Kartoffel/WTherm/measurements/13122014.xlsx

Sheet: 13122014
Time | meter value (MJ) | Qin(MJ) | inside (°C) | outside (°C) | dT (°C) | Qloss (MJ) | Qnet (MJ)
6:00:02 | 410 | 0 | 15.3 | 2 | 13.3 | 1.451182539 | -1.451182539 | Constant temperature (12:30-19:30)
6:05:02 | 413 | 3 | 15.3 | 2 | 13.3 | 1.45118254 | 0.09763492124
6:10:02 | 416 | 6 | 15.3 | 2 | 13.3 | 1.451182538 | 1.646452384 | Average dT | 14.29294118 | °C
6:15:01 | 417 | 7 | 15.4 | 2 | 13.4 | 1.457220041 | 1.189232343 | Total energy needed: | 36.38888889 | KWh
6:20:01 | 419 | 9 | 15.4 | 2 | 13.4 | 1.462093685 | 1.727138658 | Total time: | 7:00:00 | Hours
6:25:02 | 421 | 11 | 15.5 | 2 | 13.5 | 1.477914848 | 2.24922381 | Power needed: | 5.20 | KW
6:30:01 | 423 | 13 | 15.5 | 2.1 | 13.4 | 1.457220041 | 2.792003769 | Ct = | 363.704897 | W/K
6:35:02 | 425 | 15 | 15.6 | 2.2 | 13.4 | 1.466967332 | 3.325036437
6:40:02 | 427 | 17 | 15.7 | 2.2 | 13.5 | 1.473004836 | 3.852031601 | Heating up (06:00-12:00)
6:45:02 | 429 | 19 | 15.8 | 2.3 | 13.5 | 1.473004831 | 4.37902677
6:50:02 | 431 | 21 | 15.8 | 2.3 | 13.5 | 1.473004834 | 4.906021936 | Total energy | 155 | MJ
6:55:02 | 433 | 23 | 15.9 | 2.3 | 13.6 | 1.483915978 | 5.422105958 | Total time | 6.00 | Hours
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
