Kartoffel/WTherm/measurements/KNMI.xlsx

YYYYMMDD | HH | Time | Outside | Inside | Source for outside temperatures: ROYAL NETHERLANDS METEOROLOGICAL INSTITUTE (KNMI)
20141215 | 1 | 20141215 1:00 | 3.3 | 18.0 | Station: De Bilt, Utrecht, The Netherlands
20141215 | 2 | 20141215 2:00 | 3.6 | 18.0
20141215 | 3 | 20141215 3:00 | 3.9 | 18.0
20141215 | 4 | 20141215 4:00 | 3.9 | 18.0
20141215 | 5 | 20141215 5:00 | 4.0 | 18.0 | U (W/K) | 364
20141215 | 6 | 20141215 6:00 | 4.4 | 18.0 | Day | Tout (°C) | Tin (°C) | Time(hours) | Wasted energy (KWh)
20141215 | 7 | 20141215 7:00 | 4.9 | 18.0 | 4 | 10.8 | 20.0 | 1.3 | 4.35344
20141215 | 8 | 20141215 8:00 | 5.2 | 18.0 | 5 | 11.5 | 20.0 | 1.4 | 4.3316
20141215 | 9 | 20141215 9:00 | 5.6 | 18.0 | 6 | 7.8 | 20.0 | 0.9 | 3.99672
20141215 | 10 | 20141215 10:00 | 6.1 | 18.0 | 7 | 6.5 | 20.0 | 0.6 | 2.9484
20141215 | 11 | 20141215 11:00 | 6.7 | 18.0 |  |  |  | Total | 15.63016 | KWh
20141215 | 12 | 20141215 12:00 | 7.0 | 18.0 |  |  |  |  | 7.31491488 | GJ
20141215 | 13 | 20141215 13:00 | 7.6 | 18.0
20141215 | 14 | 20141215 14:00 | 7.2 | 18.0 |  |  |  | €/GJ | 22.64
20141215 | 15 | 20141215 15:00 | 6.7 | 18.0 |  |  |  | € | 165.6096729
20141215 | 16 | 20141215 16:00 | 6.3 | 18.0
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
