Kartoffel/WTherm/report/figures/GraphModelTest.png

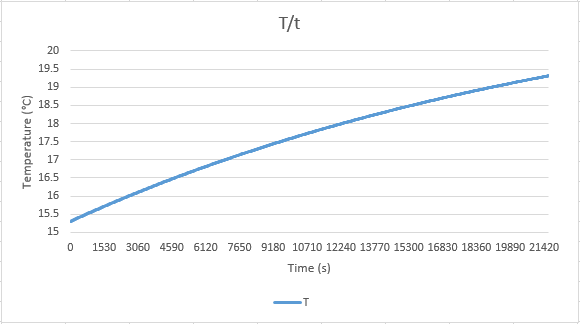
report/figures/GraphModelTest.png
