Kartoffel/WTherm/schematics/relay.pdf

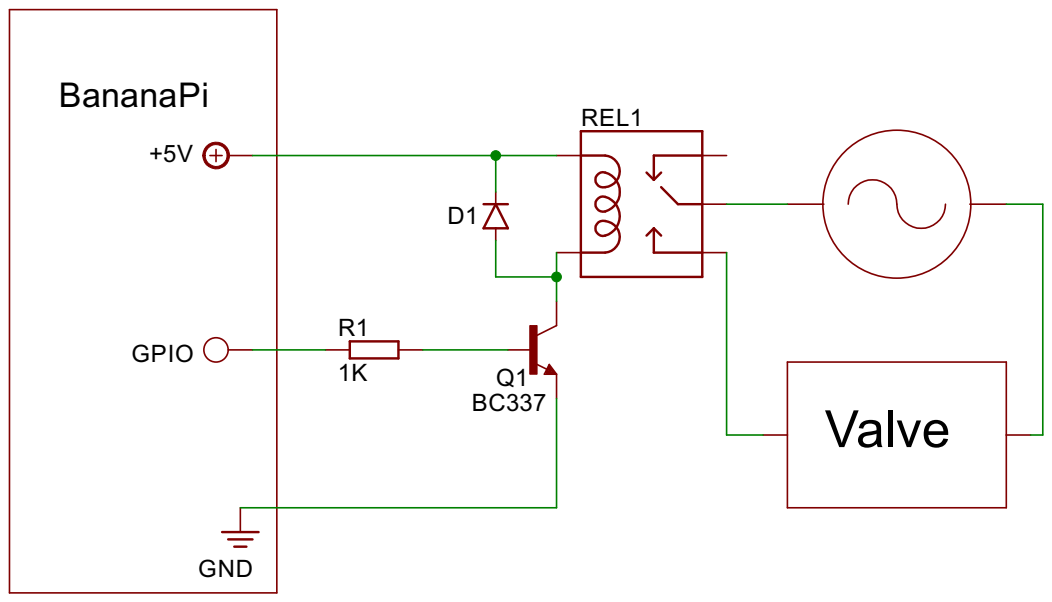
[picture p29: page 1]
