Kartoffel/WTherm/report/figures/by-nc-sa.pdf

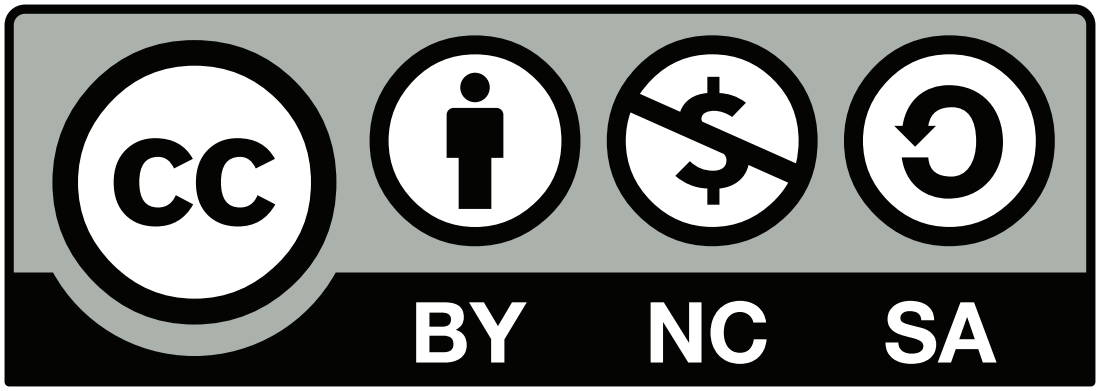
[picture p30: page 1]
