Kartoffel/WTherm/report/figures/overview.pdf

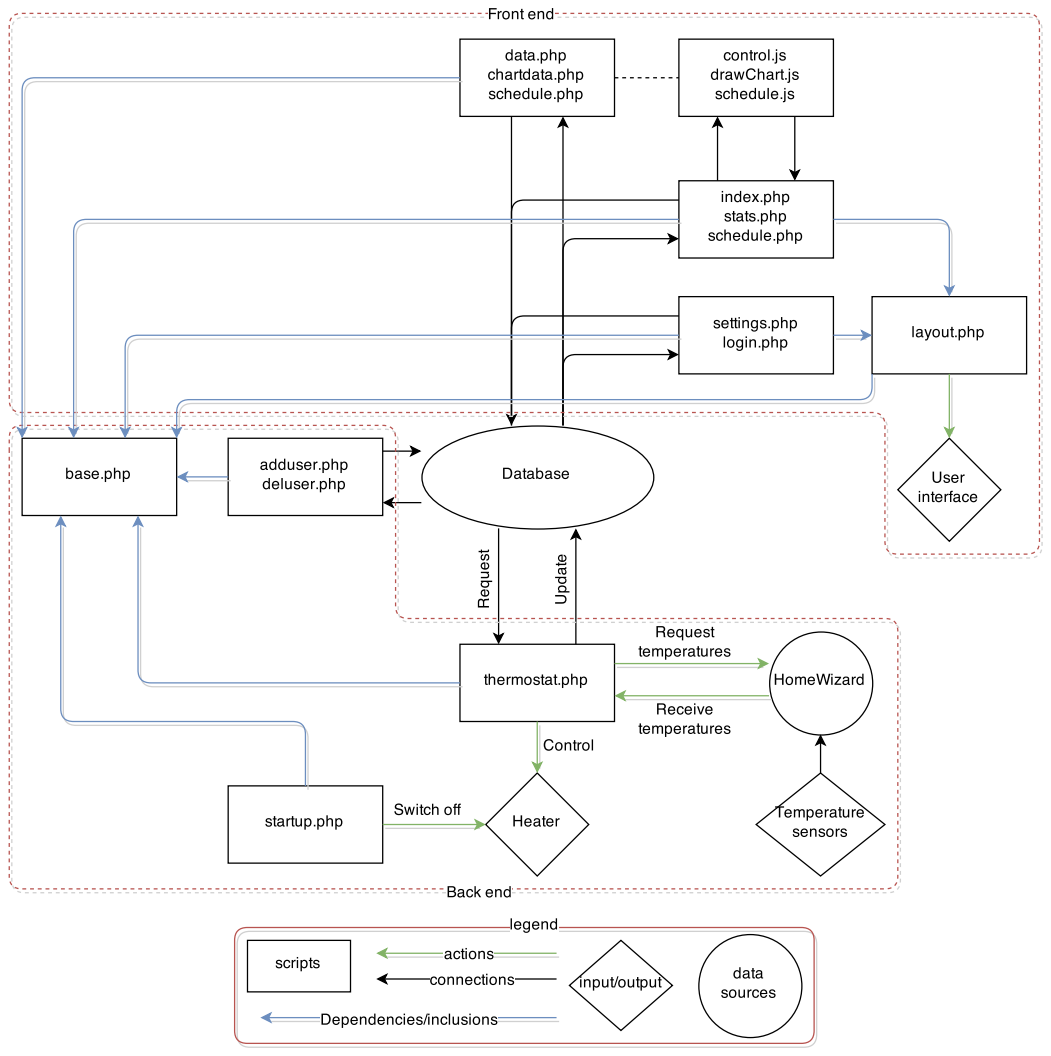
[picture p31: page 1]
