Kartoffel/WTherm/report/figures/thermostat.php.pdf

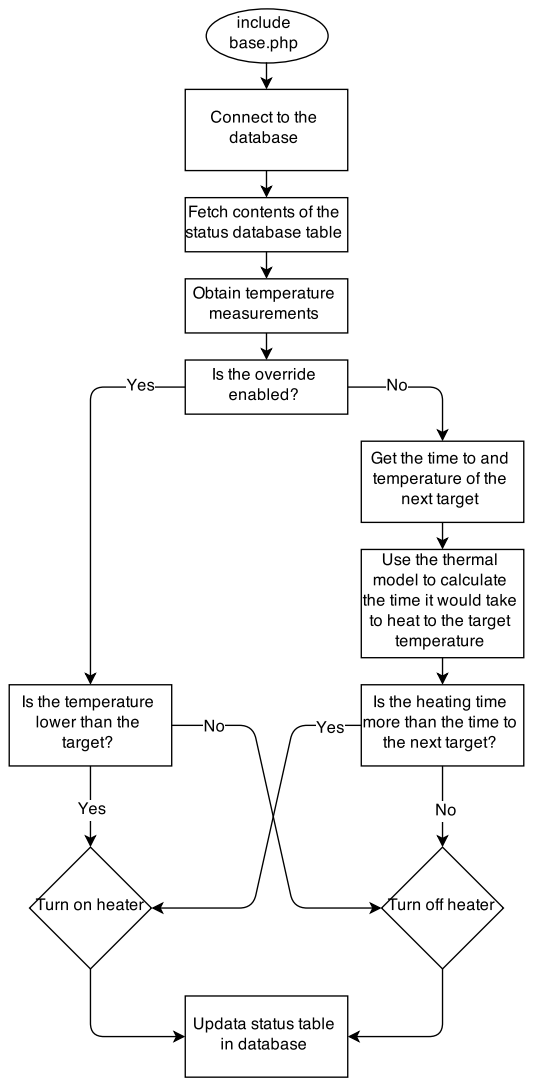
[picture p32: page 1]
