Kartoffel/WTherm/schematics/relay.sch

## EAGLE design schematics/relay.sch (2015-01-18)

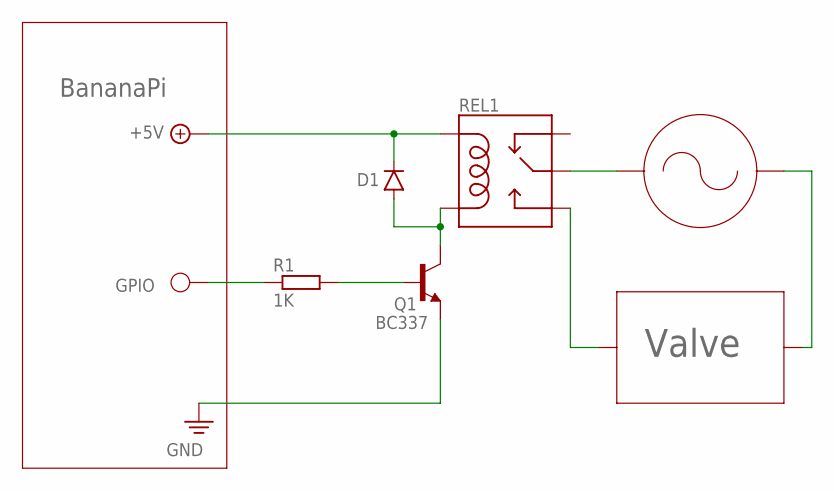
[picture p33: schematic relay.sch]

Parts:
D1: DIODE; DIODE-1N4001-KIT
Q1: BC337; TO92
R1: 1K; 0207/15
REL1: RELAYPTH; RELAY-G5Q

Connections:
+5V: D1.C, REL1.5 (COIL1)
unnamed: Q1.2 (B), R1.2
unnamed: D1.A, Q1.3 (C), REL1.1 (COIL2)
PE: Q1.1 (E)

Notes on the sheet:
BananaPi
GPIO
Valve
