Kartoffel/WTherm/(commit log)

2015-01-18 First commit
    Added code, measurements, datasheets, schematics, model
    [06122014.csv, 06122014.xlsx, 13122014.csv, 13122014.xlsx, model.xlsx, relay.sch]
2015-01-30 Added report, updated code
    [06122014.csv, 06122014.xlsx, 13122014.csv, 13122014.xlsx, KNMI.xlsx]
